winreboot/apiary-ears/(commit log)

2026-09-11 Apiary Ears: wiring, firmware, scoring and a self-hosted page
2026-09-14 v1.3.0: self-check and restart from the page, rail voltage monitoring
2026-09-15 v1.3.1: clarify that the rail monitor is optional, not a sensor fault
2026-09-15 v1.4.0: day-long fingerprint map, full sensor snapshot per recording, rail monitor removed
2026-09-15 v1.4.1: fix temperature quantisation, post-rest contamination and over-eager auto-scaling
    [apiary_ears.ino]
2026-09-15 v1.4.2: fix use-before-declaration that broke the 1.4.1 build
    [apiary_ears.ino]
2026-09-15 v1.7.0: equaliser bars with peak-hold, average ticks, sound-over-time heatmap; v1.6.4 AI hive analysis (OpenRouter or OpenAI, bring your own key)
